irq777/CLIMAX2001/Climax2001_back.JPG

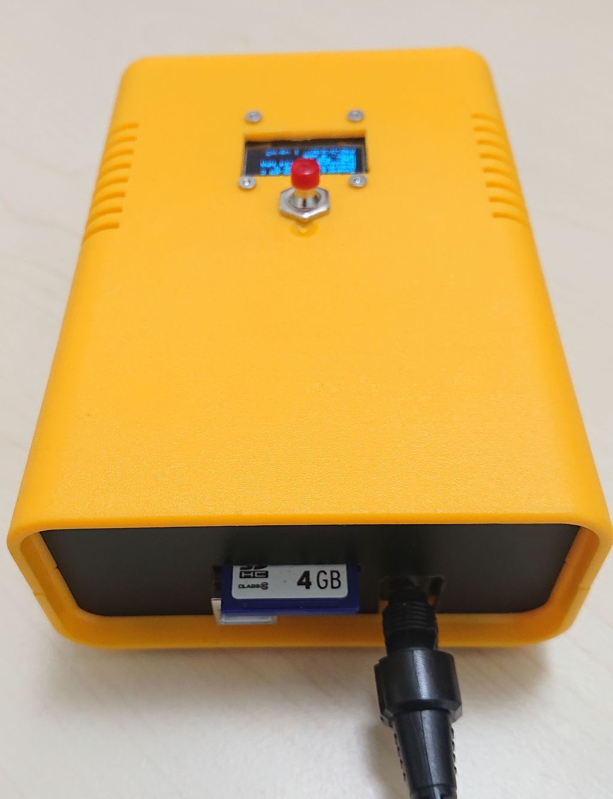
Climax2001_back.JPG
