irq777/CLIMAX2001/Climax2001_sensors.JPG

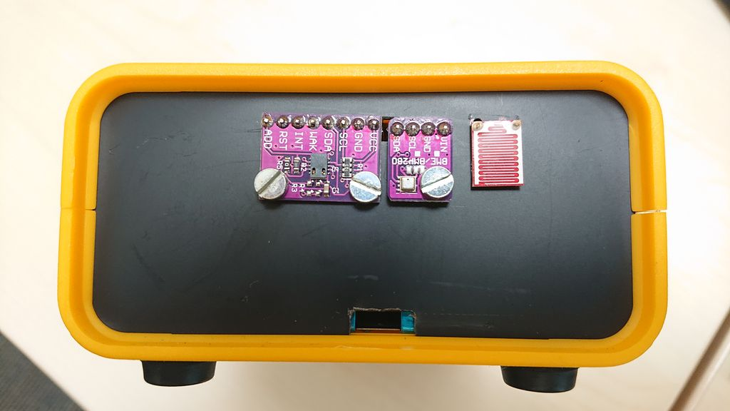
Climax2001_sensors.JPG
