irq777/CLIMAX2001/Climax2001_bottom.JPG

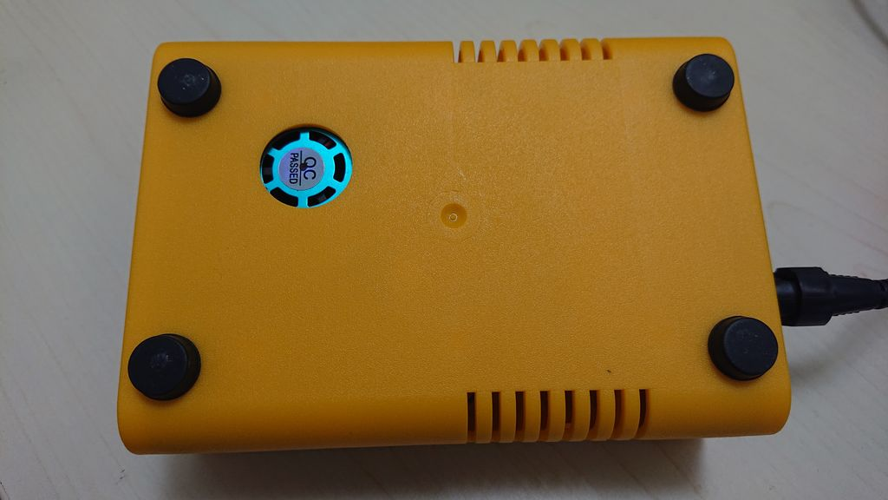
Climax2001_bottom.JPG
