irq777/CLIMAX2001/Climax2001_front.JPG

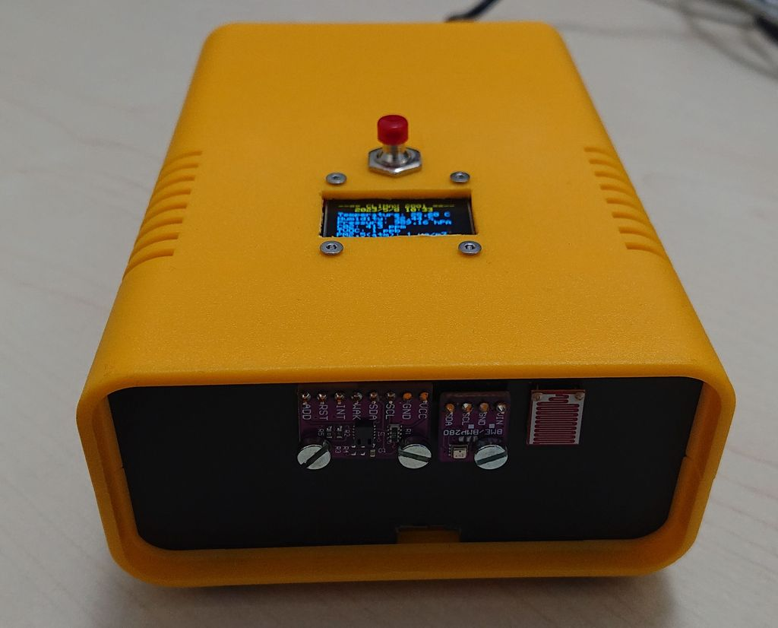
Climax2001_front.JPG
