irq777/CLIMAX2001/Climax2001_top.JPG

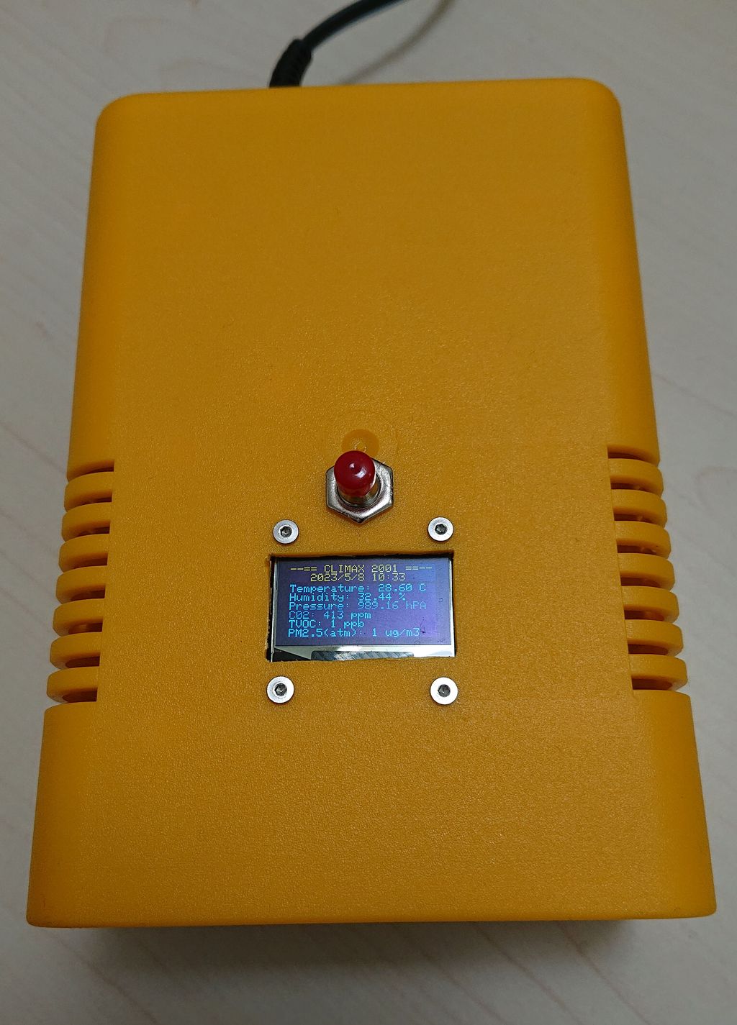
Climax2001_top.JPG
