irq777/CLIMAX2001/(threads)

Thread 2 (2023-10-05):

Logging stops over time

irq777, 2023-10-05:
After some time of logging the device stalls/freezes.
Looks like it's a memory leakage that happens within 24h.
According to logs on memory usage (see below), it starts leaking after around 5h.
The leakage was not present in previous implementations. It either come in with using new sensors or with new library versions.
It's 100% reproducible. The time-span it occurs may varies.

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

irq777, 2024-08-05:
Probably fixed with commit 6989379. Now allow to call oled.clear() only once when we are in the loop(). Before the function was called always. This may cause issues on I2C bus due so many calls. Let's test a little bit longer and close afterwards.

irq777, 2024-08-08:
Fixed with commit 6989379. The device runs now for 3 days without crash 🥳

Closed 2024-08-08.

Thread 3 (2024-01-08):

Issues on porting project to Uno R4 Wifi

irq777, 2024-01-08:
- Issue with Library https://github.com/greiman/SSD1306Ascii only compatible with AVR boards (I2C driver is the reason)
 - Try to use the big(!) Adafruit display library?
- Without display-support there is an error in the library for the HM3301
 - Wait until library supports ESP?

irq777, 2024-12-07:
Without display-support there is an error in the library for the HM3301 in case the library is installed via Arduino IDE.
The issue is gone when the library is downloaded and copied locally to e.g. C:\Users\USERNAME\Documents\Arduino\libraries.

Thread 4 (2024-07-09):

SCD30 temperature offset

irq777, 2024-07-09:
Looks like there is an offset in the temperature measured my the SCD30 that is ~+2.5°C higher (needs to be verified).
Probably also the humidity is wrong.
- Measure the precise temperature offset and add to the code

irq777, 2025-05-11:
SCD30 Temp offset issue is due a used heater for the CO2 measurements according to:
[https://github.com/sparkfun/SparkFun_SCD30_Arduino_Library/issues/27]

I think that way the temperature measurement is probably good enough for compensation of the CO2 measurements, but not linear enough to work as accurate temperature measurements.

Closed 2024-07-10.

Thread 5 (2024-08-08):

Feature: Show filename during bootup

irq777, 2024-08-08:
Show the filename during bootup and also print an error if we reached the maximum number of files (=100).

Thread 6 (2024-12-01):

BME280 sensor can't be added on top

irq777, 2024-12-01:
The initialization of the BME280 (humidity/temperature/pressure) fails when added together withe the SCD30 and the HM3301. probably due to insufficient resources. E.g. without the SCD30 compiled in it works.

irq777, 2025-05-11:
The issue did not occur anymore.

Closed 2025-05-11.

Thread 7 (2024-12-01):

Add DCF77 to fix switching daylight saving time

irq777, 2024-12-01:
The RTC seems not to support daylight saving time.
Using the DCF77 could fix it.
