irq777/CLIMAX2001/(commit log)

2023-05-06 Added PM2.5 Laser Dust Detector from Seeedstudio.
2023-05-06 Added HM3301 Seeed PM2.5 Dust Detection Sensor and DCF77
    DCF77 is not working and crashing when dcfEvaluateSequence() is called
    Added LED support for the datalogging shield used to debug DCF77 by toogling green & red LED when an interrupt is received and when time is updated.
    [Climax2000.ino]
2023-05-07 Fix display issue and upgraded to Climax2001 :-)
    [Climax2000.ino]
2023-05-08 Pictures from housing
2023-08-26 Added Sensirion SCD30 CO2 sensor module
    - Added SCD30 Sensirion CO2/Temperature/Humidity sensor module using the Adafruit library
    - Disabled CJMCU-811 CO2/TVOC Sensor module (replaced by SCD30. TVOC is not available)
    - Use BME280 Humidity/Temperature/Barometer sensor only for pressure if SCD30 in enabled
    - LCD shows now PM1 instead of pressure
    - Add more compiler-switches for proper logging in case individual sensor-modules are enabled/disabled
    - Delay startup by one more second to let give the sensors some time to initialize (before SCD30 showed zero for temp/humid) at the first measurement)
    [Climax2000.ino]
2024-01-08 Add files via upload
    - Added DEBUG mode to log memory usage
    - OLED: Commented RST_PIN out
    - Cleanup serial prining in case some modules are disabled
    - OLED: Don't print HN3301 data if module is disabled
    - OLED: Initialize OLED always when activated via button
    - OLED: Avoid writing to OLED in a loop in case it's set permanent to on (that probably crashed the device in short measuring intervals)
    [Climax2001.ino]
2024-07-10 Debugging improvements and temperature offset compensation added
    - compiler-switch added to disable logging to SD
    - disable BME280
    - added SCD30 temperature offset to compensate the PCB that gets warm (issue#4)
    - added SCD30 measurement interval
    - added SCD30 altitude compensation
    - added SCD30 self calibration (but disabled)
    - debugging improvements
    [Climax2001.ino]
2024-07-15 Add files via upload
    Optimize temperature compensation
2024-08-05 Avoid call oled.clear() in a loop and several minor optimizations.
    Removed Wire.begin()
    Change value for SCD30_TEMP_OFFSET
    Add debigging for oled.clear()
    Allow to call oled.clear() only once when we are in the loop(). Before the function was called always.
    Improve compiler-flags for different sensors in case they are individually deactivated
    [Climax2001.ino]
2024-12-01 Added RGB LED feature and removed Dallas DS1820 one-wire sensor
    Added RGB LED to project to visually indicate CO2 levels:
    <600 green
    <1000 light green
    <1500 orange
    >=1500 red
    Adjust RGB brightness depending on LDR
    RGB LED is Cyan during booting
    Removed Dallas DS1820 one-wire sensor from project
    Removed debugging via leds on Adafruit Arduino datalogging shield as the pios were needed for the RGB LED
    Added definitions of pins to better understand current wiring and usage
2025-05-11 Add files via upload
    - Catch compilations which are not for AVR due to incompatibility of "SSD1306Ascii" library
    - Improved offset-handling for BME280
    - BME280 activated as the temperature-measurement is more accurate than the SCD30
    - BME280 activated to have pressure-measurement
    - Use BME280 temperature and humidity instead of SCD30
    - Find better temp-compensation offsets for BME280 and SCD30
    - Print on OLED in case the logfile cannot be written to SD-card
    - Improved debugging
    [Climax2001.ino]
